TanmayDeuskar/STM32_board/STM32_boardv2.kicad_pcb

## KiCad design STM32_boardv2.kicad_pcb (2024-07-08)

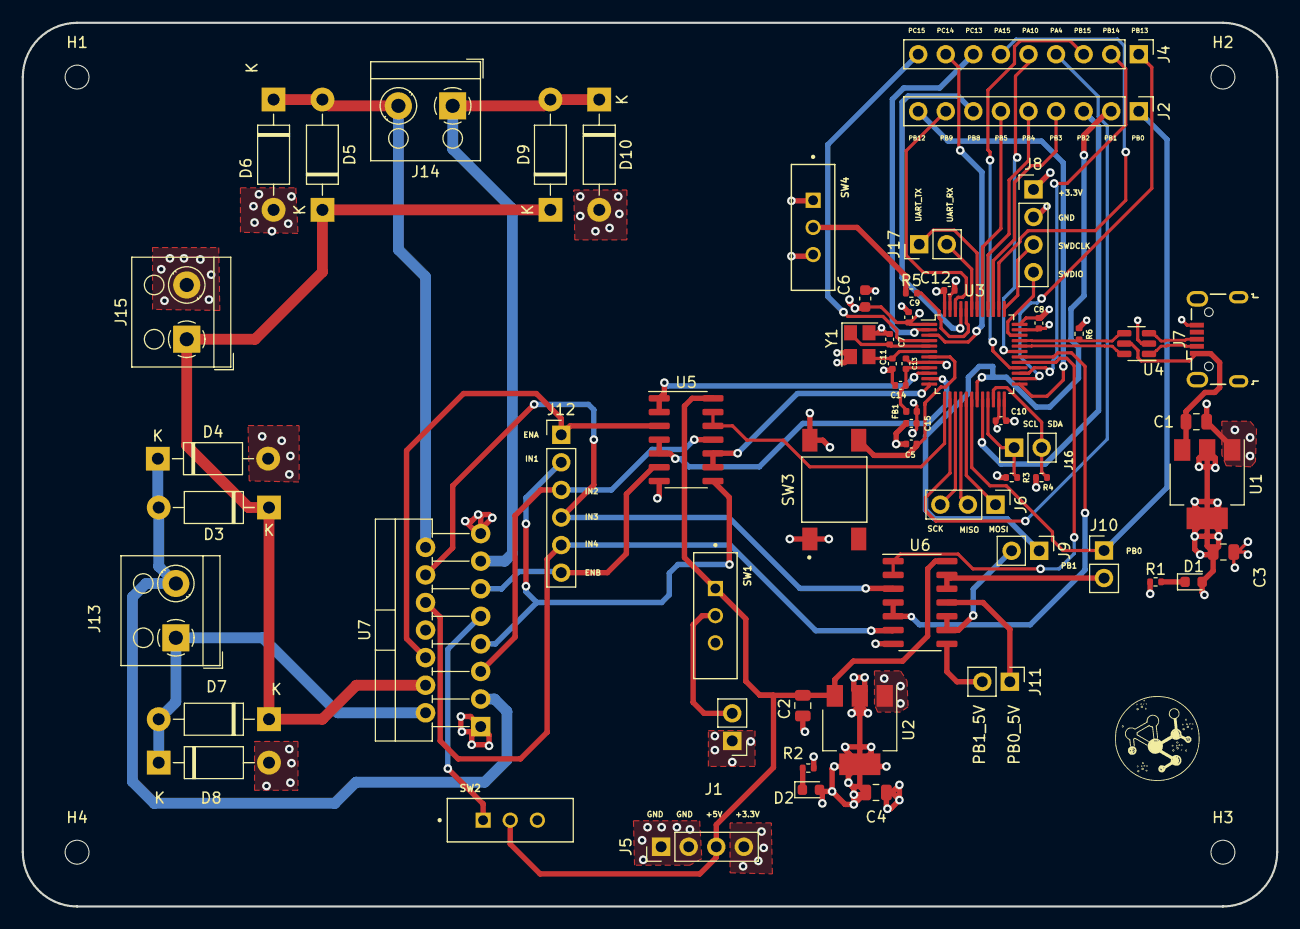
[picture p1: board STM32_boardv2.kicad_pcb from above]

Board: 4 copper layers, 115.5 x 81.4 mm, 64 parts (0 on the bottom side), 66 nets.

Parts:
C1, C2, C3, C4: 22u; C_0805_2012Metric
C5, C8, C9, C10, C12: 100n; C_0402_1005Metric
C6: 10u; C_0603_1608Metric
C7, C11: 27p; C_0402_1005Metric
C13: 10n; C_0402_1005Metric
C14, C15: 1u; C_0402_1005Metric
D1, D2: LED; LED_0603_1608Metric
D3, D4, D5, D6, D7, D8, D9, D10: 1N4007; D_DO-41_SOD81_P10.16mm_Horizontal
FB1: 120R; L_0402_1005Metric
H1, H2, H3, H4: MountingHole; MountingHole_2.2mm_M2
J1, J9, J10, J11, J16, J17: Conn_01x02_Pin; PinHeader_1x02_P2.54mm_Vertical
J2, J4: Conn_01x09_Pin; PinHeader_1x09_P2.54mm_Vertical
J5, J8: Conn_01x04_Pin; PinHeader_1x04_P2.54mm_Vertical
J6: Conn_01x03_Pin; PinHeader_1x03_P2.54mm_Vertical
J7: USB_B_Micro; USB_Micro-B_Wuerth_629105150521
J12: Conn_01x06_Pin; PinHeader_1x06_P2.54mm_Vertical
J13, J14, J15: Screw_Terminal_01x02; TerminalBlock_RND_205-00001_1x02_P5.00mm_Horizontal
R1, R2, R3, R4, R6: 1K5; R_0402_1005Metric
R5: 10K; R_0402_1005Metric
SW1, SW2, SW4: SW_SPDT; SW_MINI-SPDT-SW
SW3: SW_MEC_5G; SW_4-1437565-1
U1, U2: AMS1117-3.3; SOT-223-3_TabPin2
U3: STM32F103C8T6; LQFP-48_7x7mm_P0.5mm
U4: USBLC6-2SC6; SOT-23-6
U5, U6: SN74HCT08N; SO-14_3.9x8.65mm_P1.27mm
U7: L298N; TO-220-15_P2.54x2.54mm_StaggerOdd_Lead4.58mm_Vertical
Y1: 16MHz; Crystal_SMD_3225-4Pin_3.2x2.5mm

Connections:
+3.3V: C3.1, C4.1, C6.1, C8.1, C9.1, C10.1, C12.1, C15.1, D1.2 (A), D2.2 (A), FB1.2, J5.4, J8.1, R3.1, R4.1, R6.1, SW4.3 (C), U1.2 (VO), U2.2 (VO), U3.1 (VBAT), U3.24 (VDD), U3.36 (VDD), U3.48 (VDD)
+3.3VA: C13.1, C14.1, FB1.1, U3.9 (VDDA)
+5V: C2.1, J5.3, SW1.1 (A), SW2.2 (B), U2.3 (VI), U5.14 (VCC), U6.14 (VCC)
+12V: D3.1 (K), D5.1 (K), D7.1 (K), D9.1 (K), J15.1, U7.4 (Vs)
/BOOT0: R5.2, U3.44 (BOOT0)
/CR_IN: C7.1, U3.5 (PD0), Y1.1
/CR_OUT: C11.1, U3.6 (PD1), Y1.3
/I2C2_SCL: J16.1, R3.2, U3.21 (PB10)
/I2C2_SDA: J16.2, R4.2, U3.22 (PB11)
/NRST: C5.1, SW3.3 (B), SW3.4 (B), U3.7 (NRST)
/SPI1_MISO: J6.2, U3.16 (PA6)
/SPI1_MOSI: J6.1, U3.17 (PA7)
/SPI1_SCK: J6.3, U3.15 (PA5)
/SWDCLK: J8.3, U3.37 (PA14)
/SWDIO: J8.4, U3.34 (PA13)
/SW_BOOT0: R5.1, SW4.2 (B)
/USART1_RX: J17.2, U3.43 (PB7)
/USART1_TX: J17.1, U3.42 (PB6)
/USB_CONN_D+: J7.3 (D+), U4.3 (I/O2)
/USB_CONN_D-: J7.2 (D-), U4.1 (I/O1)
/VIN: J1.2, SW1.2 (B)
ENA: J12.1, U5.3 (1Y), U7.6 (EnA)
ENB: J12.6, U5.6 (2Y), U7.11 (EnB)
GND: C1.2, C2.2, C3.2, C4.2, C5.2, C6.2, C7.2, C8.2, C9.2, C10.2, C11.2, C12.2, C13.2, C14.2, C15.2, D4.2 (A), D6.2 (A), D8.2 (A), D10.2 (A), J1.1, J5.1, J5.2, J7.5 (GND), J8.2, J15.2, R1.1, R2.1, SW3.1 (A), SW3.2 (A), SW4.1 (A), U1.1 (GND), U2.1 (GND), U3.8 (VSSA), U3.23 (VSS), U3.35 (VSS), U3.47 (VSS), U4.2 (GND), U5.7 (GND), U6.7 (GND), U7.1 (SENSE_A), U7.8 (GND), U7.15 (SENSE_B), Y1.2, Y1.4
IN1: J12.2, U5.8 (3Y), U7.7 (IN2)
IN2: J12.3, U5.11 (4Y), U7.5 (IN1)
IN3: J12.4, U6.3 (1Y), U7.12 (IN4)
IN4: J12.5, U6.6 (2Y), U7.10 (IN3)
unnamed: D1.1 (K), R1.2
unnamed: D2.1 (K), R2.2
unnamed: J9.2, U6.9 (3A), U6.10 (3B)
unnamed: J10.2, U6.12 (4A), U6.13 (4B)
unnamed: J11.1, U6.11 (4Y)
unnamed: J11.2, U6.8 (3Y)
unnamed: SW2.1 (A), U7.9 (Vss)
unnamed: U3.10 (PA0), U5.1 (1A), U5.2 (1B)
unnamed: U3.11 (PA1), U5.4 (2A), U5.5 (2B)
unnamed: U3.12 (PA2), U5.9 (3A), U5.10 (3B)
unnamed: U3.13 (PA3), U5.12 (4A), U5.13 (4B)
OUT1: D7.2 (A), D8.1 (K), J13.1, U7.2 (OUT1)
OUT2: D3.2 (A), D4.1 (K), J13.2, U7.3 (OUT2)
OUT3: D9.2 (A), D10.1 (K), J14.1, U7.13 (OUT3)
OUT4: D5.2 (A), D6.1 (K), J14.2, U7.14 (OUT4)
PA4: J4.4, U3.14 (PA4)
PA10: J4.5, U3.31 (PA10)
PA15: J4.6, U3.38 (PA15)
PB0: J2.1, J10.1, U3.18 (PB0)
PB1: J2.2, J9.1, U3.19 (PB1)
PB2: J2.3, U3.20 (PB2)
PB3: J2.4, U3.39 (PB3)
PB4: J2.5, U3.40 (PB4)
PB5: J2.6, U3.41 (PB5)
PB8: J2.7, U3.45 (PB8)
PB9: J2.8, U3.46 (PB9)
PB12: J2.9, U3.25 (PB12)
PB13: J4.1, U3.26 (PB13)
PB14: J4.2, U3.27 (PB14)
PB15: J4.3, U3.28 (PB15)
PC13: J4.7, U3.2 (PC13)
PC14: J4.8, U3.3 (PC14)
PC15: J4.9, U3.4 (PC15)
U4_1A: U3.29 (PA8), U6.1 (1A), U6.2 (1B)
U4_1B: U3.30 (PA9), U6.4 (2A), U6.5 (2B)
USB_D+: R6.2, U3.33 (PA12), U4.4 (I/O2)
USB_D-: U3.32 (PA11), U4.6 (I/O1)
VBUS: C1.1, J7.1 (VBUS), U1.3 (VI), U4.5 (VBUS)
